akhlut/OSPID/OSPID/arduino pid motor C/arduino pid motor C/pid2.png

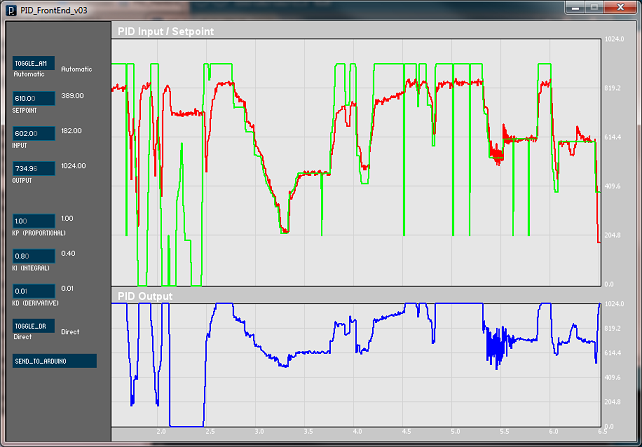
OSPID/arduino pid motor C/arduino pid motor C/pid2.png
