akhlut/OSPID/OSPID/arduino pid motor C/arduino pid motor C/readme.txt

copy LCD4Bit and pid folders in to arduino libraries.

compile and burn to chip.

schematic is made in proteus.

fell free to modify and improve it :D

have fun
