akhlut/OSPID/OSPID/5cbmyt.jpg

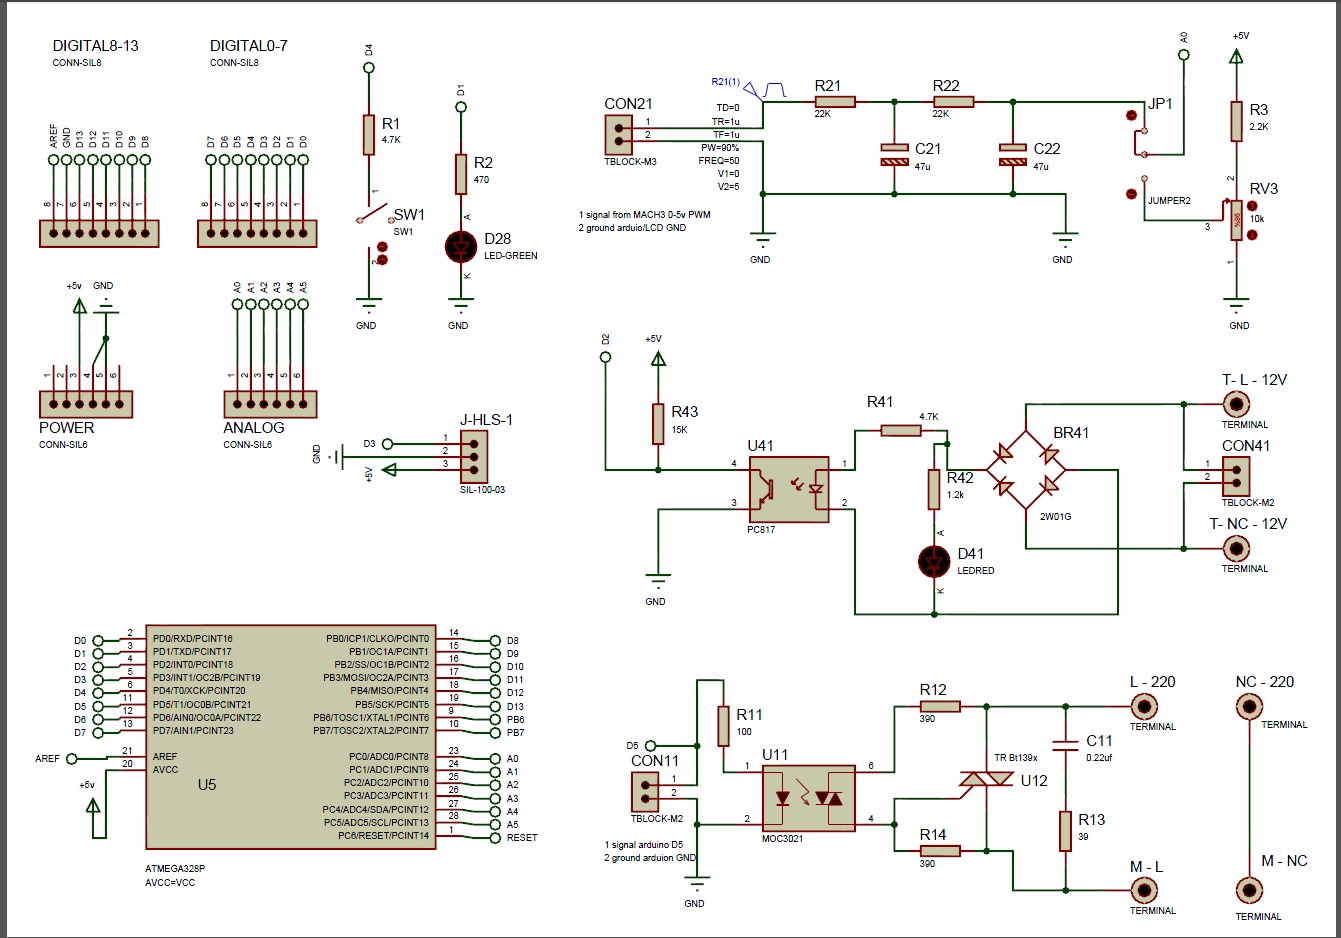
OSPID/5cbmyt.jpg
