akhlut/OSPID/OSPID/arduino pid motor C/arduino pid motor C/arduino-zero-1.do.bmp

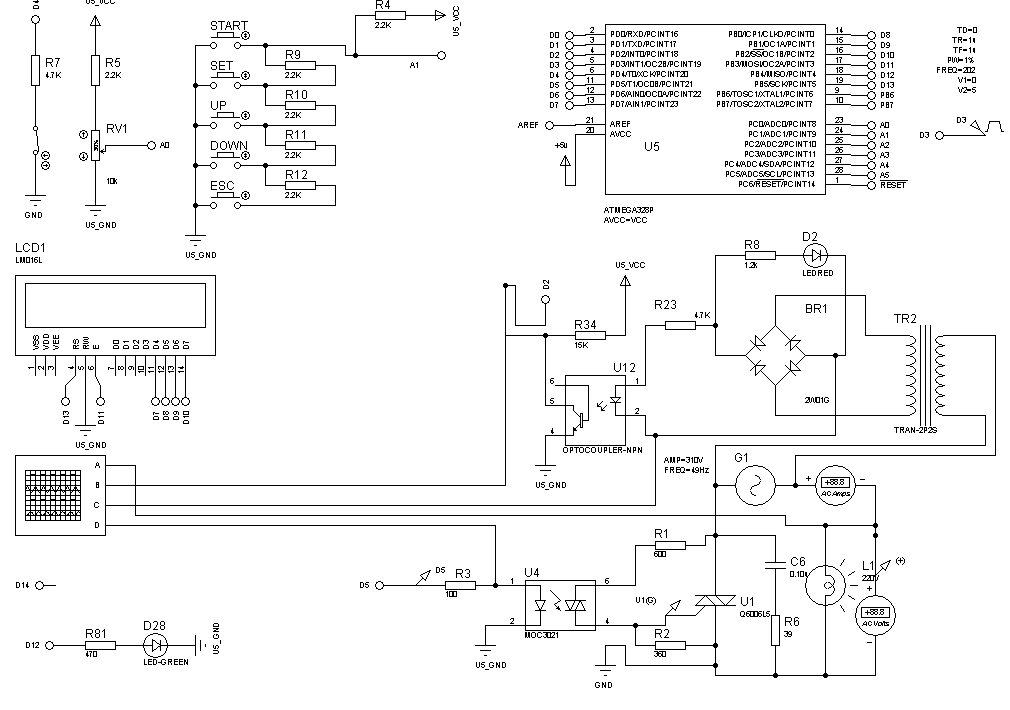
OSPID/arduino pid motor C/arduino pid motor C/arduino-zero-1.do.bmp
