akhlut/OSPID/OSPID/eagle2.bmp

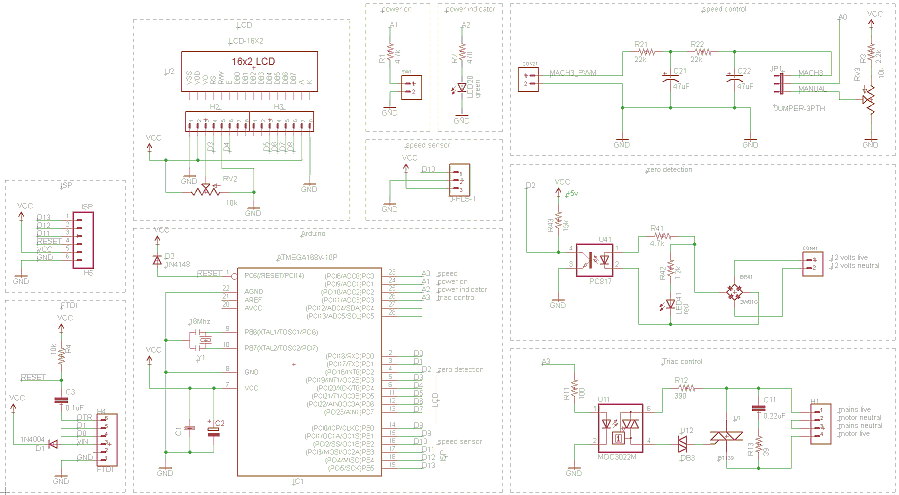
OSPID/eagle2.bmp
