akhlut/OSPID/OSPID/phase84_v0_4170.jpg

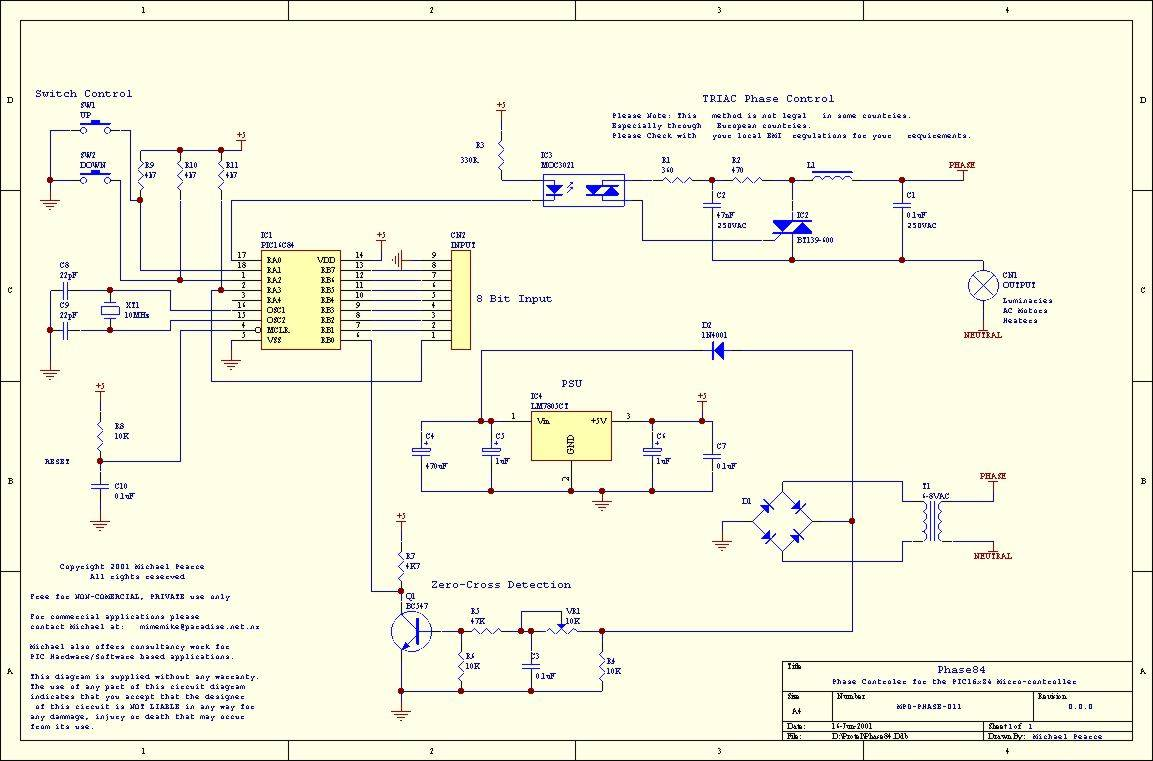
OSPID/phase84_v0_4170.jpg
