akhlut/OSPID/OSPID/SpindlePidLcdCopper (1).bmp

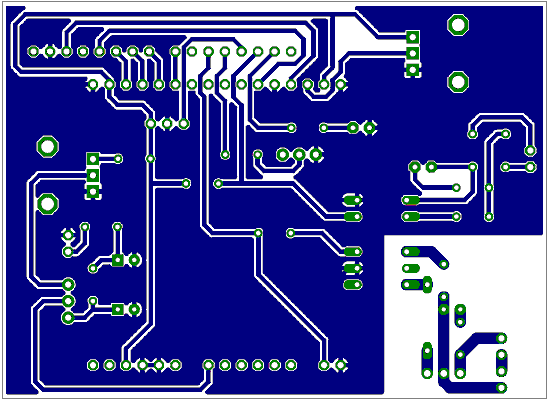
OSPID/SpindlePidLcdCopper (1).bmp
