akhlut/OSPID/pcb/LCD pcb/final.dxf

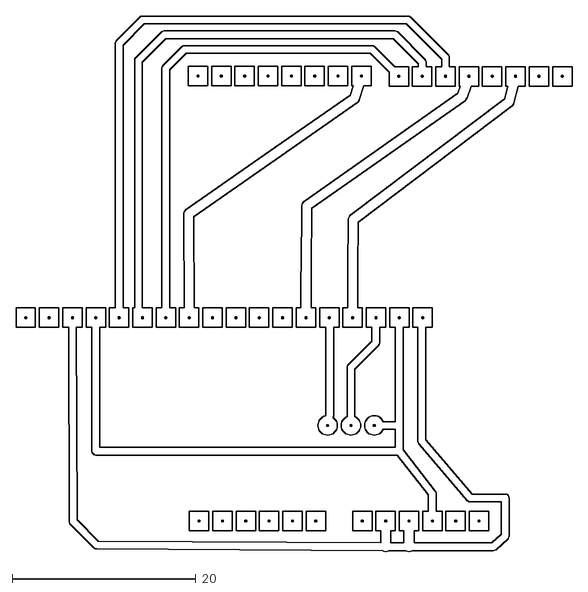
[picture p7: CAD file, 2013-12-27]
pcb/LCD pcb/final.dxf
60.5 x 58.3
