akhlut/OSPID/pcb/Main pcb/last-2-mill.dxf

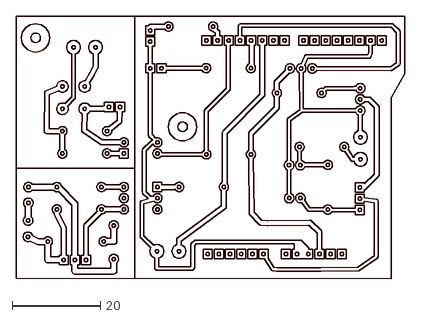
[picture p8: CAD file, 2013-12-27]
pcb/Main pcb/last-2-mill.dxf
88.3 x 59.8
