akhlut/OSPID/pcb/LCD pcb/GERBVIEW.DXF

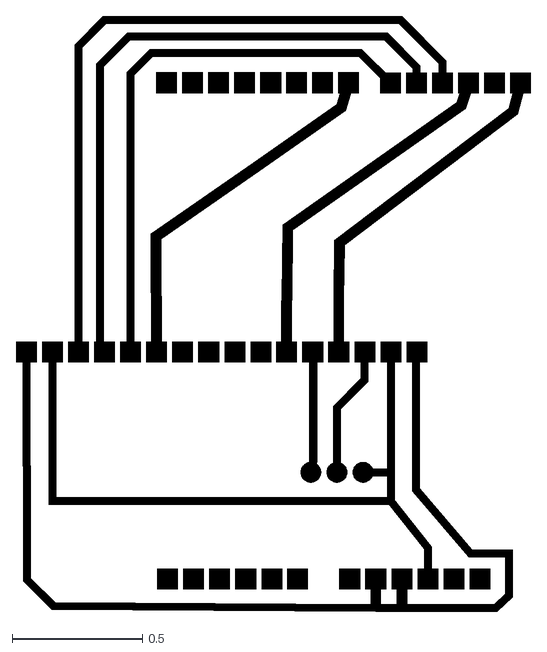
[picture p9: CAD file, 2013-12-27]
pcb/LCD pcb/GERBVIEW.DXF
1.98 x 2.28
