akhlut/OSPID/pcb/Main pcb/last-2.dxf

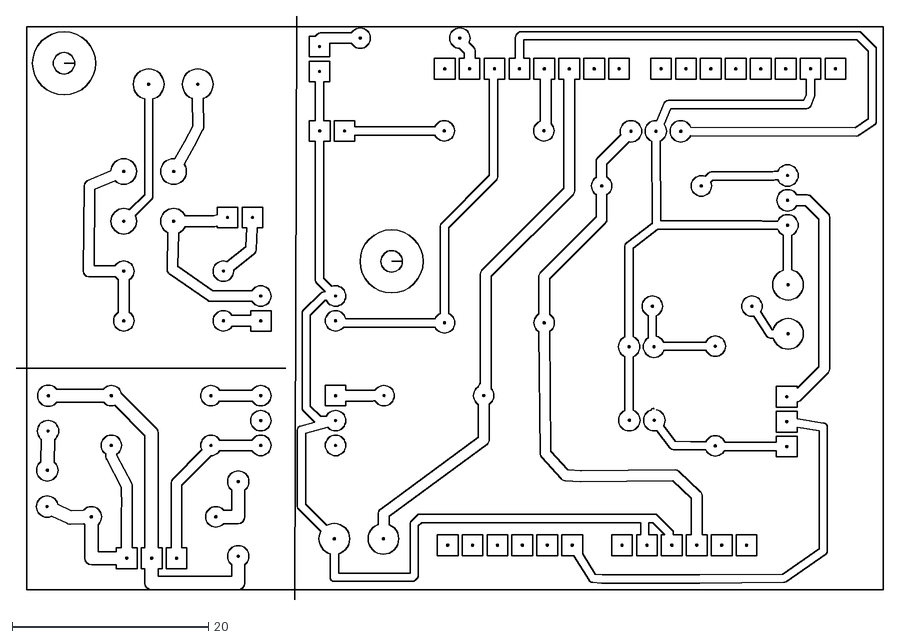
[picture p10: CAD file, 2013-12-27]
pcb/Main pcb/last-2.dxf
88.4 x 59.5
