akhlut/OSPID/OSPID/SpindlePID/SpindlePID.pdf

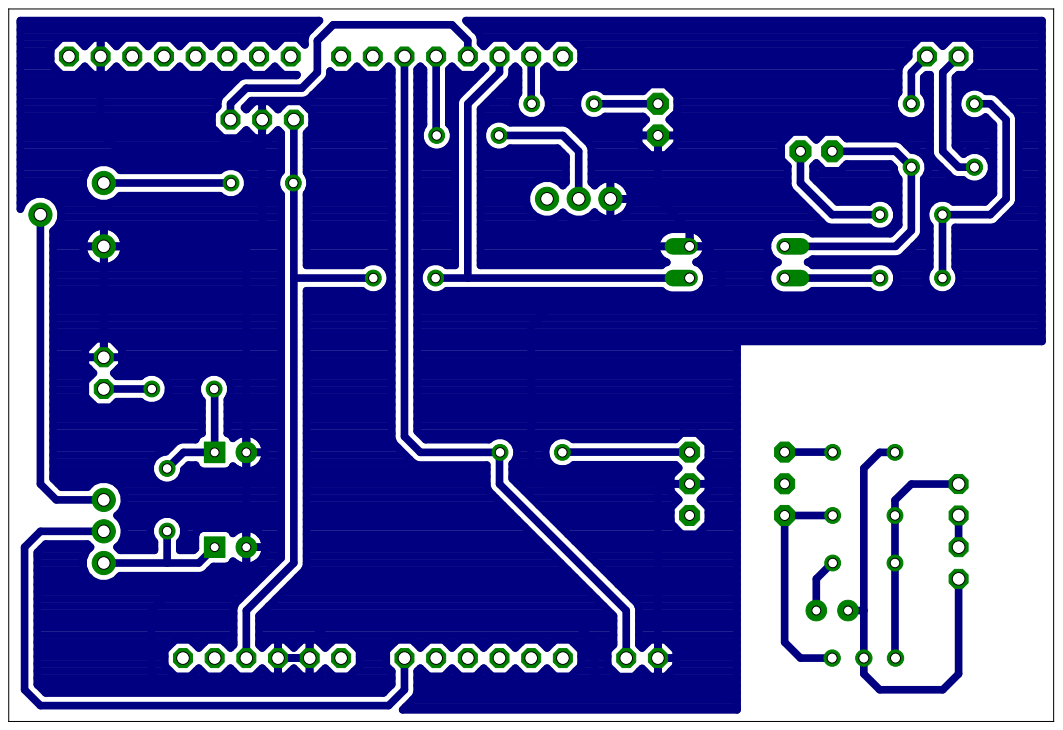
[picture p43: page 1]
