akhlut/OSPID/(list of files, drawings)

Other design files:
OpenSpindle/OpenSpindle BASE.dsn
OSPID/arduino pid motor C/arduino pid motor C/Arduino-Zero-1-n-3(Proteus).DSN
pcb/LCD pcb/Arduino-Zero-1-n-7-LCD-SHIELD.DSN
pcb/LCD pcb/Arduino-Zero-1-n-7-LCD-SHIELD.LYT
pcb/LCD pcb/GERBVIEW.LYT
pcb/Main pcb/GERBVIEW.LYT
