akhlut/OSPID/OSPID/OSPID/OSPID4.brd

## EAGLE design OSPID/OSPID/OSPID4.brd (2013-12-27)

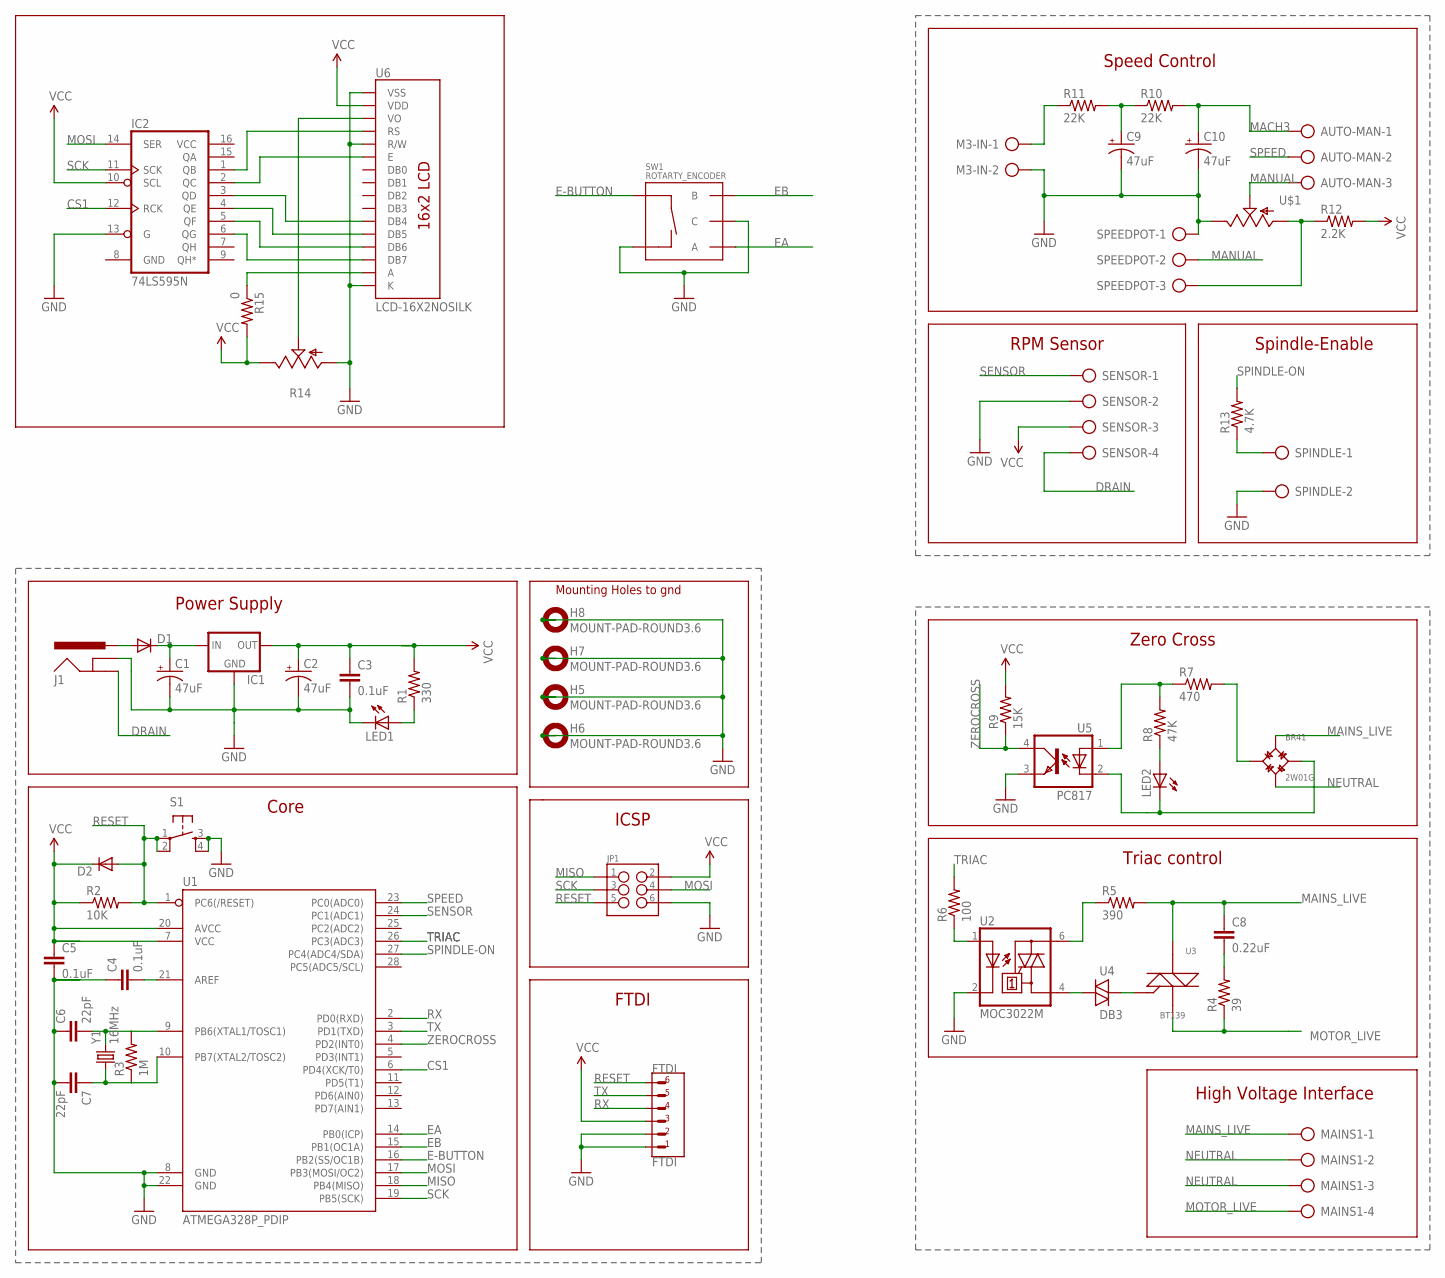
[picture p44: schematic OSPID4.sch]

Parts:
AUTO-MAN: AK500/3
BR41: 2W01G; DIODEBRIDGE
C1, C2, C9, C10: 47uF; CPOL-RADIAL-10UF-25V
C3, C4, C5: 0.1uF; CAP-PTH-SMALL
C6, C7: 22pF; CAP-PTH-SMALL
C8: 0.22uF; CAP-PTH-SMALL
D1, D2: DIODEPTH; DIODE-1N4001
FTDI: FTDI; 6PINHEADER
H5, H6, H7, H8: MOUNT-PAD-ROUND3.6; 3,6-PAD
IC1: V_REG_78XX-TO-220; TO-220-ALT
IC2: 74LS595N; DIL16
J1: POWER_JACKPTH_LOCK; POWER_JACK_PTH_LOCK
JP1: M03X2POGO_PINS; 2X3_POGO
LED1, LED2: LED5MM
M3-IN: AK500/2
MAINS1: AK500/4
R1: 330; AXIAL-0.3
R2: 10K; AXIAL-0.3
R3: 1M; AXIAL-0.3
R4: 39; AXIAL-0.3
R5: 390; AXIAL-0.3
R6: 100; AXIAL-0.3
R7: 470; SQM_5-10
R8: 47K; SQM_5-10
R9: 15K; AXIAL-0.3
R10, R11: 22K; AXIAL-0.3
R12: 2.2K; AXIAL-0.3
R13: 4.7K; AXIAL-0.3
R14: POT_TRIM_US-B25U; POT_B25U
R15: 0; AXIAL-0.3
S1: TAC_SWITCHPTH; TACTILE-PTH
SENSOR: AK500/4
SPEEDPOT: AK500/3
SPINDLE: AK500/2
SW1: ROTARTY_ENCODER; ROTARY_ENC_PLAIN
U1: ATMEGA328P_PDIP; DIL28-3
U2: MOC3022M; DIL06
U3: BT139; TRIAC
U4: DB3; DO35-10
U5: PC817; DIL04
U6: LCD-16X2NOSILK; LCD-16X2_NOSILK
U$1: POT; ALPS_POT
Y1: 16MHz; HC49U-V

Connections:
CS1: IC2.12 (RCK), U1.6 (PD4(XCK/T0))
DRAIN: J1.GND, SENSOR.4
E-BUTTON: SW1.SW+, U1.16 (PB2(SS/OC1B))
EA: SW1.A, U1.14 (PB0(ICP))
EB: SW1.B, U1.15 (PB1(OC1A))
GND: C1.2 (-), C2.2 (-), C3.2, C4.1, C5.2, C6.1, C7.2, C9.2 (-), C10.2 (-), FTDI.P$1, FTDI.P$2, H5.B3,6, H6.B3,6, H7.B3,6, H8.B3,6, IC1.GND, IC2.8 (GND), IC2.13 (G), J1.GNDBREAK, JP1.P$6 (6), LED1.K (C), M3-IN.2, R14.A, S1.3, S1.4, SENSOR.2, SPEEDPOT.1, SPINDLE.2, SW1.C, SW1.SW-, U1.8 (GND), U1.22 (GND), U2.2 (C), U5.3 (EMIT), U6.1 (VSS), U6.5 (R/W), U6.16 (K), U$1.P$1 (E)
MACH3: AUTO-MAN.1, C10.1 (+), R10.P$2 (2)
MACH3_PWM: M3-IN.1, R11.P$1 (1)
MAINS_LIVE: BR41.AC1, C8.1, MAINS1.1, R5.P$2 (2), U3.2 (A)
MANUAL: AUTO-MAN.3, SPEEDPOT.2, U$1.P$2 (S)
MISO: JP1.P$1 (1), U1.18 (PB4(MISO))
MOSI: IC2.14 (SER), JP1.P$4 (4), U1.17 (PB3(MOSI/OC2))
MOTOR_LIVE: MAINS1.4, R4.P$1 (1), U3.3 (C)
unnamed: U3.1 (B), U4.C (2)
unnamed: C9.1 (+), R10.P$1 (1), R11.P$2 (2)
unnamed: U2.4 (A1), U4.A (1)
unnamed: LED1.A, R1.P$1 (1)
unnamed: C8.2, R4.P$2 (2)
unnamed: R7.P1 (1), R8.P2 (2), U5.1 (A)
unnamed: BR41.-, LED2.K (C), U5.2 (C)
unnamed: LED2.A, R8.P1 (1)
unnamed: R12.P$1 (1), SPEEDPOT.3, U$1.P$3 (A)
unnamed: R13.P$1 (1), SPINDLE.1
unnamed: R6.P$1 (1), U2.1 (A)
unnamed: R14.S, U6.3 (VO)
unnamed: R5.P$1 (1), U2.6 (A2)
unnamed: R15.P$1 (1), U6.15 (A)
unnamed: IC2.1 (QB), U6.4 (RS)
unnamed: IC2.2 (QC), U6.6 (E)
unnamed: C7.1, R3.P$1 (1), U1.10 (PB7(XTAL2/TOSC2)), Y1.1
unnamed: IC2.6 (QG), U6.14 (DB7)
unnamed: C6.2, R3.P$2 (2), U1.9 (PB6(XTAL1/TOSC1)), Y1.2
unnamed: IC2.5 (QF), U6.13 (DB6)
unnamed: IC2.4 (QE), U6.12 (DB5)
unnamed: C1.1 (+), D1.C, IC1.IN
unnamed: D1.A, J1.PWR
unnamed: IC2.3 (QD), U6.11 (DB4)
unnamed: C4.2, U1.21 (AREF)
unnamed: BR41.+, R7.P2 (2)
NEUTRAL: BR41.AC2, MAINS1.2, MAINS1.3
RESET: D2.A, FTDI.P$6, JP1.P$5 (5), R2.P$2 (2), S1.1, S1.2, U1.1 (PC6(/RESET))
RX: FTDI.P$4, U1.2 (PD0(RXD))
SCK: IC2.11 (SCK), JP1.P$3 (3), U1.19 (PB5(SCK))
SENSOR: SENSOR.1, U1.24 (PC1(ADC1))
SPEED: AUTO-MAN.2, U1.23 (PC0(ADC0))
SPINDLE-ON: R13.P$2 (2), U1.27 (PC4(ADC4/SDA))
TRIAC: R6.P$2 (2), U1.26 (PC3(ADC3))
TX: FTDI.P$5, U1.3 (PD1(TXD))
VCC: C2.1 (+), C3.1, C5.1, D2.C, FTDI.P$3, IC1.OUT, IC2.10 (SCL), IC2.16 (VCC), JP1.P$2 (2), R1.P$2 (2), R2.P$1 (1), R9.P$2 (2), R12.P$2 (2), R14.E, R15.P$2 (2), SENSOR.3, U1.7 (VCC), U1.20 (AVCC), U6.2 (VDD)
ZEROCROSS: R9.P$1 (1), U1.4 (PD2(INT0)), U5.4 (COL)

Notes on the sheet:
Speed Control
RPM Sensor
Spindle-Enable
Power Supply
Triac control
Zero Cross
FTDI
Core
ICSP
High Voltage Interface
Mounting Holes to gnd

Board: 2 copper layers, 55 parts (0 on the bottom side), 50 nets, no tracks yet.
