akhlut/OSPID/OSPID/StandAlone/SpindlePidLcdStandAlone.brd

## EAGLE design OSPID/StandAlone/SpindlePidLcdStandAlone.brd (2013-12-27)

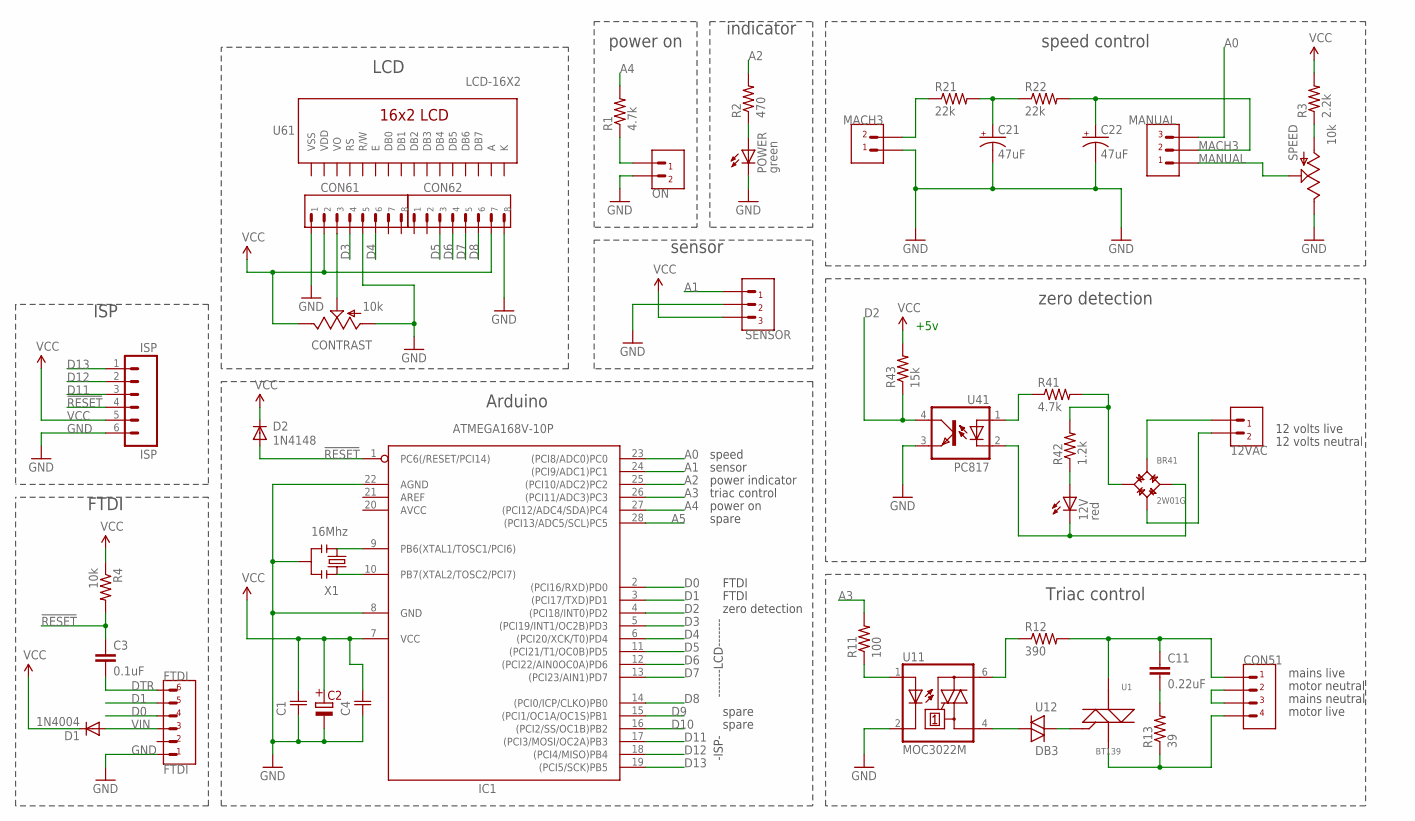
[picture p45: schematic SpindlePidLcdStandAlone.sch]

Parts:
12V: red; LED5MM
12VAC: 2PIN
BR41: 2W01G; DIODEBRIDGE
C1, C4: 0.1UF
C2: CAPACITOR
C3: 0.1uF; CAP-PTH-SMALL
C11: 0.22uF; CAP-PTH-SMALL
C21, C22: 47uF; CPOL-RADIAL-10UF-25V
CON51: 4PIN
CON61, CON62: 8PINHEADER
CONTRAST: 10k; ALPS_POT
D1: 1N4004; DO41-10
D2: 1N4148; DO41-10
FTDI: FTDI; 6PINHEADER
IC1: ATMEGA168V-10P; DIL28-3
ISP: ISP; 1X06
MACH3: 2PIN
MANUAL: 3PIN
ON: 2PIN
POWER: green; LED5MM
R1: 4.7k; AXIAL-0.4
R2: 470; 1/6W-RES
R3: 2.2k; 1/6W-RES
R4: 10k; AXIAL-0.4
R11: 100; 1/6W-RES
R12: 390; 1/6W-RES
R13: 39; 1/6W-RES
R21, R22: 22k; 1/6W-RES
R41: 4.7k; 1/6W-RES
R42: 1.2k; 1/6W-RES
R43: 15k; 1/6W-RES
SENSOR: 3PIN
SPEED: 10k; ALPS_POT
U1: BT139; TRIAC
U11: MOC3022M; DIL06
U12: DB3; DO35-10
U41: PC817; DIL04
U61: LCD-16X2
X1: 16Mhz; RESONATOR-PTH

Connections:
!RESET: C3.1, D2.A, IC1.1 (PC6(/RESET/PCI14)), ISP.4, R4.P$2 (2)
A: U61.15 (A)
A0: IC1.23 ((PCI8/ADC0)PC0), MANUAL.P$3 (3)
A1: IC1.24 ((PCI9/ADC1)PC1), SENSOR.P$1 (1)
A2: IC1.25 ((PCI10/ADC2)PC2), R2.2
A3: IC1.26 ((PCI11/ADC3)PC3), R11.2
A4: IC1.27 ((PCI12/ADC4/SDA)PC4), R1.P$2 (2)
A5: IC1.28 ((PCI13/ADC5/SCL)PC5)
D0: FTDI.P$4, IC1.2 ((PCI16/RXD)PD0)
D1: FTDI.P$5, IC1.3 ((PCI17/TXD)PD1)
D2: IC1.4 ((PCI18/INT0)PD2), R43.1, U41.4 (COL)
D3: CON61.P$4, IC1.5 ((PCI19/INT1/OC2B)PD3)
D4: CON61.P$6, IC1.6 ((PCI20/XCK/T0)PD4)
D5: CON62.P$3, IC1.11 ((PCI21/T1/OC0B)PD5)
D6: CON62.P$4, IC1.12 ((PCI22/AIN0OC0A)PD6)
D7: CON62.P$5, IC1.13 ((PCI23/AIN1)PD7)
D8: CON62.P$6, IC1.14 ((PCI0/ICP/CLKO)PB0)
D9: IC1.15 ((PCI1/OC1A/OC1S)PB1)
D10: IC1.16 ((PCI2/SS/OC1B)PB2)
D11: IC1.17 ((PCI3/MOSI/OC2A)PB3), ISP.3
D12: IC1.18 ((PCI4/MISO)PB4), ISP.2
D13: IC1.19 ((PCI5/SCK)PB5), ISP.1
DTR: C3.2, FTDI.P$6
GND: C1.P$1, C2.- (-VE), C4.P$1, C21.2 (-), C22.2 (-), CON61.P$1, CON61.P$5, CON62.P$8, CONTRAST.P$3 (A), FTDI.P$1, IC1.8 (GND), IC1.22 (AGND), ISP.6, MACH3.P$1, ON.P$2, POWER.K (C), SENSOR.P$2 (2), SPEED.P$1 (E), U11.2 (C), U41.3 (EMIT), X1.2
K: U61.16 (K)
MACH3: C22.1 (+), MANUAL.P$2 (2), R22.2
MACH3_PWM: MACH3.P$2, R21.1
MAINS_LIVE: C11.1, CON51.P$1, R12.2, U1.2 (A)
MANUAL: MANUAL.P$1 (1), SPEED.P$2 (S)
MOTOR_LIVE: CON51.P$4, R13.1, U1.3 (C)
unnamed: U1.1 (B), U12.C (2)
unnamed: C21.1 (+), R21.2, R22.1
unnamed: U11.4 (A1), U12.A (1)
unnamed: POWER.A, R2.1
unnamed: C11.2, R13.2
unnamed: 12V.A, R42.1
unnamed: R41.1, U41.1 (A)
unnamed: 12V.K (C), BR41.-, U41.2 (C)
unnamed: BR41.+, R41.2, R42.2
unnamed: R3.1, SPEED.P$3 (A)
unnamed: IC1.9 (PB6(XTAL1/TOSC1/PCI6)), X1.1
unnamed: ON.P$1, R1.P$1 (1)
unnamed: R11.1, U11.1 (A)
unnamed: 12VAC.P$1, BR41.AC1
unnamed: R12.1, U11.6 (A2)
unnamed: 12VAC.P$2, BR41.AC2
unnamed: CON61.P$3, CONTRAST.P$2 (S)
unnamed: IC1.10 (PB7(XTAL2/TOSC2/PCI7)), X1.3
NEUTRAL: CON51.P$2, CON51.P$3
VCC: C1.P$2, C2.+ (+VE), C4.P$2, CON61.P$2, CON62.P$7, CONTRAST.P$1 (E), D1.C, D2.C, IC1.7 (VCC), ISP.5, R3.2, R4.P$1 (1), R43.2, SENSOR.P$3 (3)
VDD: U61.2 (VDD)
VIN: D1.A, FTDI.P$3
VSS: U61.1 (VSS)

Notes on the sheet:
+5v
speed control
Arduino
sensor
power on
indicator
Triac control
zero detection
motor live
mains live
mains neutral
motor neutral
12 volts live
12 volts neutral
FTDI
ISP
LCD
-------LCD-------
-ISP-
speed
power indicator
triac control
spare

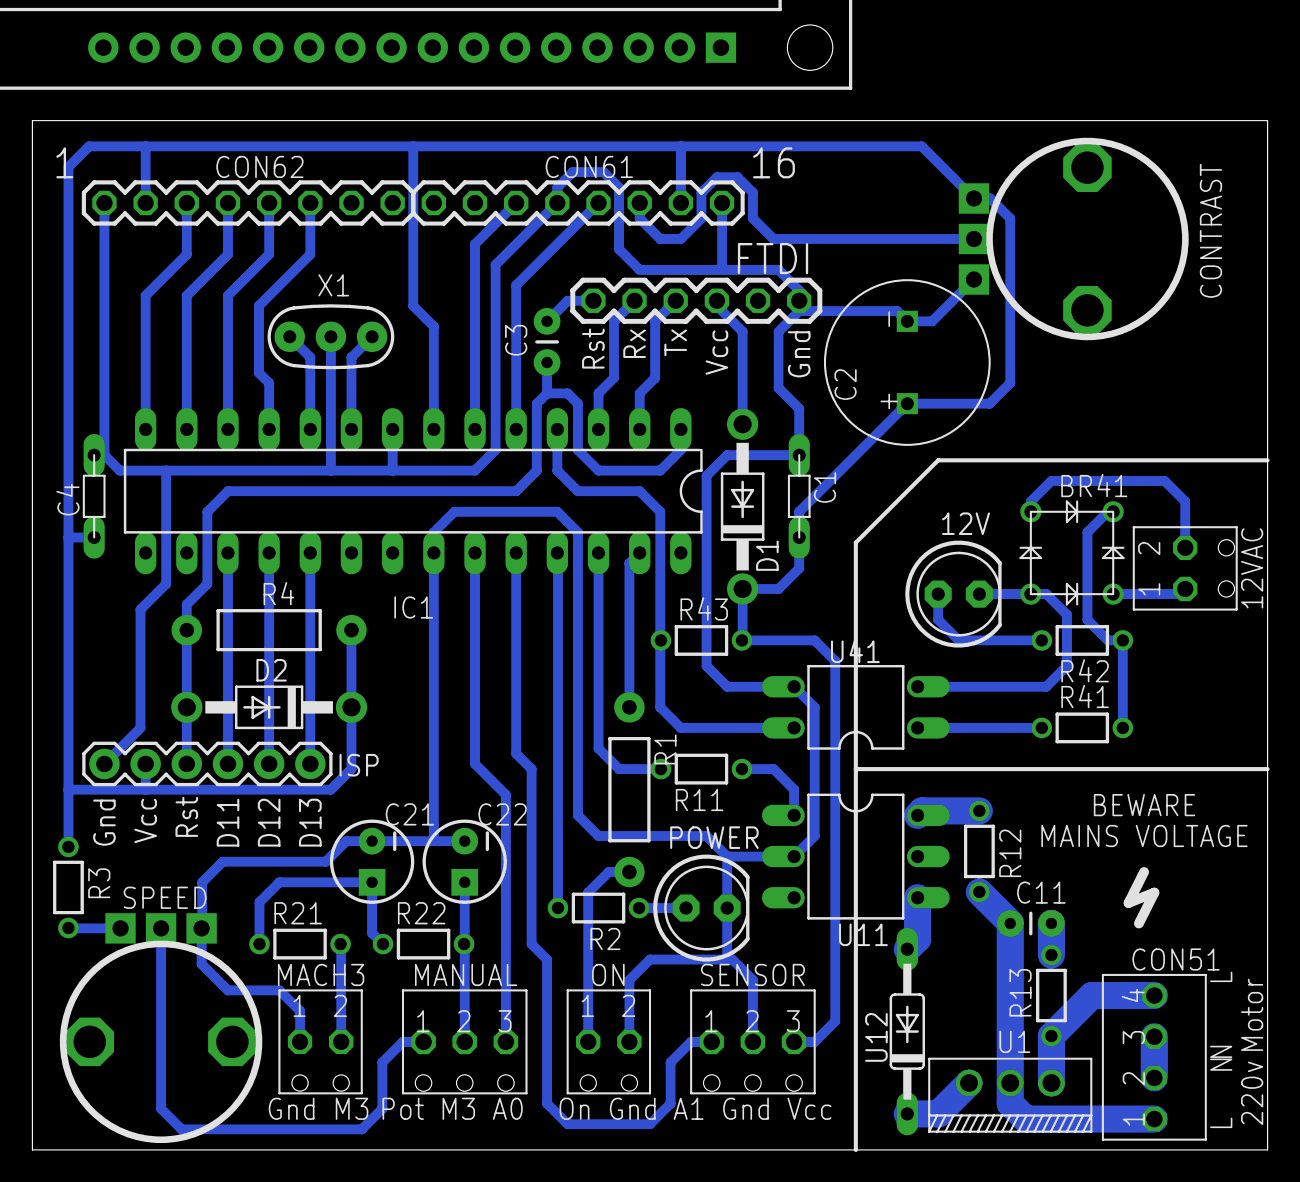
[picture p46: board SpindlePidLcdStandAlone.brd from above]

Board: 2 copper layers, 76.2 x 63.5 mm, 43 parts (0 on the bottom side), 46 nets.
