akhlut/OSPID/OSPID/SpindlePID/SpindlePID.brd

## EAGLE design OSPID/SpindlePID/SpindlePID.brd (2013-12-27)

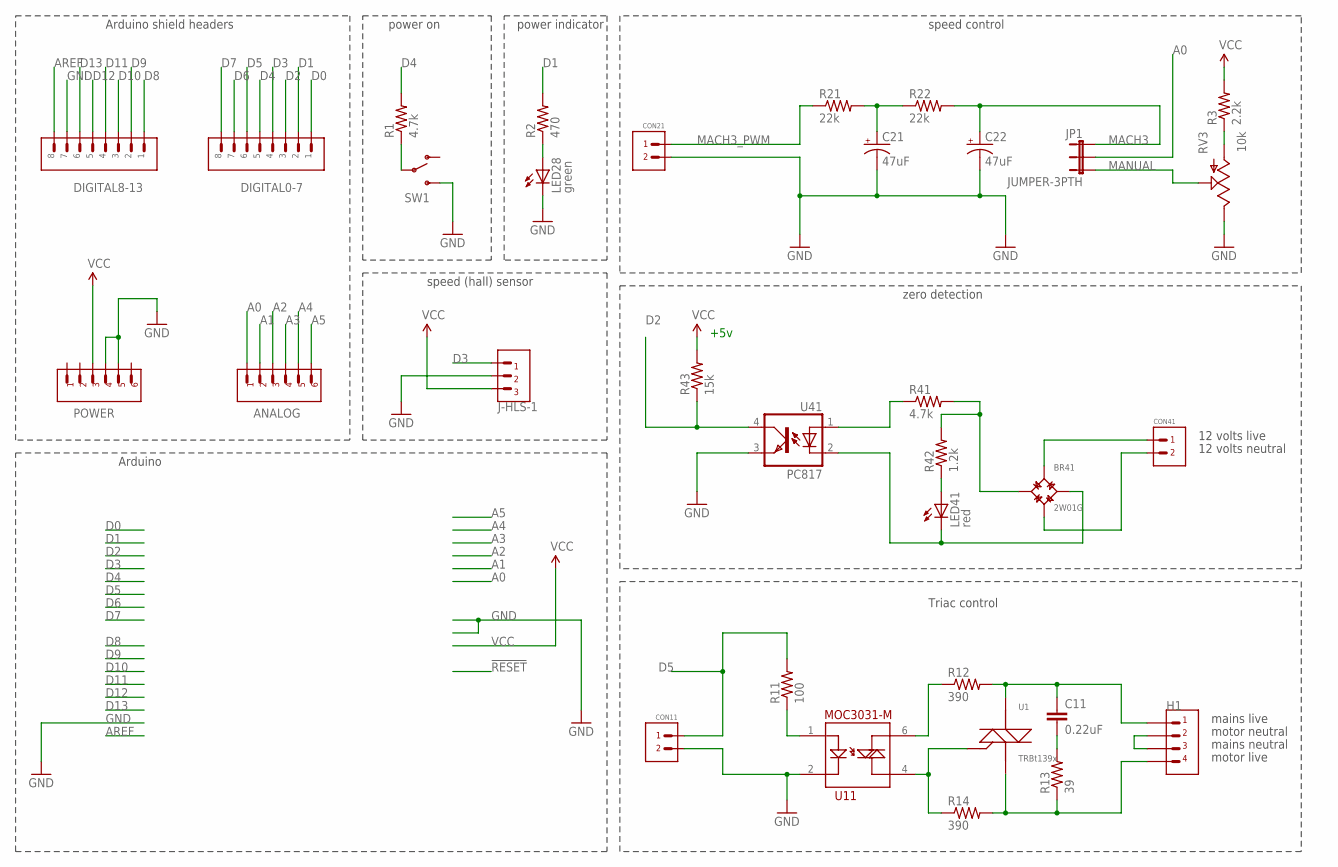
[picture p47: schematic SpindlePID.sch]

Parts:
ANALOG: 6PINHEADER0.1"; 6PINHEADER
BR41: 2W01G; DIODEBRIDGE
C11: 0.22uF; CAP-PTH-SMALL
C21, C22: 47uF; CPOL-RADIAL-10UF-25V
CON11, CON21, CON41: 2PINHEADER
DIGITAL0-7, DIGITAL8-13: 8PINHEADER
H1: 4PIN
J-HLS-1: 3PINHEADER
JP1: JUMPER-3PTH; 1X03
LED28: green; LED5MM
LED41: red; LED5MM
POWER: 6PINHEADER0.1"; 6PINHEADER
R1, R41: 4.7k; 1/6W-RES
R2: 470; 1/6W-RES
R3: 2.2k; 1/6W-RES
R11: 100; 1/6W-RES
R12, R14: 390; 1/6W-RES
R13: 39; 1/6W-RES
R21, R22: 22k; 1/6W-RES
R42: 1.2k; 1/6W-RES
R43: 15k; 1/6W-RES
RV3: 10k; TRIM_POT
SW1: SWITCH-SPSTPTH; SWITCH-SPDT
U1: TRBt139x; TRIAC
U11: MOC3031-M; DIL06
U41: PC817; DIL04

Connections:
A0: ANALOG.P$1, JP1.2
A1: ANALOG.P$2
A2: ANALOG.P$3
A3: ANALOG.P$4
A4: ANALOG.P$5
A5: ANALOG.P$6
AREF: DIGITAL8-13.P$8
D0: DIGITAL0-7.P$1
D1: DIGITAL0-7.P$2, R2.2
D2: DIGITAL0-7.P$3, R43.1, U41.4 (COL)
D3: DIGITAL0-7.P$4, J-HLS-1.P$3
D4: DIGITAL0-7.P$5, R1.2
D5: CON11.P$1, DIGITAL0-7.P$6, R11.2
D6: DIGITAL0-7.P$7
D7: DIGITAL0-7.P$8
D8: DIGITAL8-13.P$1
D9: DIGITAL8-13.P$2
D10: DIGITAL8-13.P$3
D11: DIGITAL8-13.P$4
D12: DIGITAL8-13.P$5
D13: DIGITAL8-13.P$6
GND: C21.2 (-), C22.2 (-), CON11.P$2, CON21.P$2, DIGITAL8-13.P$7, J-HLS-1.P$2, LED28.K (C), POWER.P$4, POWER.P$5, RV3.2 (E), SW1.3 (S), U11.2, U41.3 (EMIT)
MACH3: C22.1 (+), JP1.1, R22.2
MACH3_PWM: CON21.P$1, R21.1
MAINS_LIVE: C11.1, H1.P$1, R12.2, U1.2 (A)
MANUAL: JP1.3, RV3.1 (S)
MOTOR_LIVE: H1.P$4, R13.1, R14.2, U1.3 (C)
unnamed: C21.1 (+), R21.2, R22.1
unnamed: R14.1, U1.1 (B), U11.4
unnamed: LED28.A, R2.1
unnamed: C11.2, R13.2
unnamed: LED41.A, R42.1
unnamed: R41.1, U41.1 (A)
unnamed: BR41.-, LED41.K (C), U41.2 (C)
unnamed: BR41.+, R41.2, R42.2
unnamed: R3.1, RV3.3 (A)
unnamed: R1.1, SW1.2
unnamed: R11.1, U11.1
unnamed: BR41.AC1, CON41.P$1
unnamed: R12.1, U11.6
unnamed: BR41.AC2, CON41.P$2
NEUTRAL: H1.P$2, H1.P$3
VCC: J-HLS-1.P$1, POWER.P$3, R3.2, R43.2

Notes on the sheet:
+5v
speed control
Arduino shield headers
Arduino
speed (hall) sensor
power on
power indicator
Triac control
zero detection
motor live
mains live
mains neutral
motor neutral
12 volts live
12 volts neutral

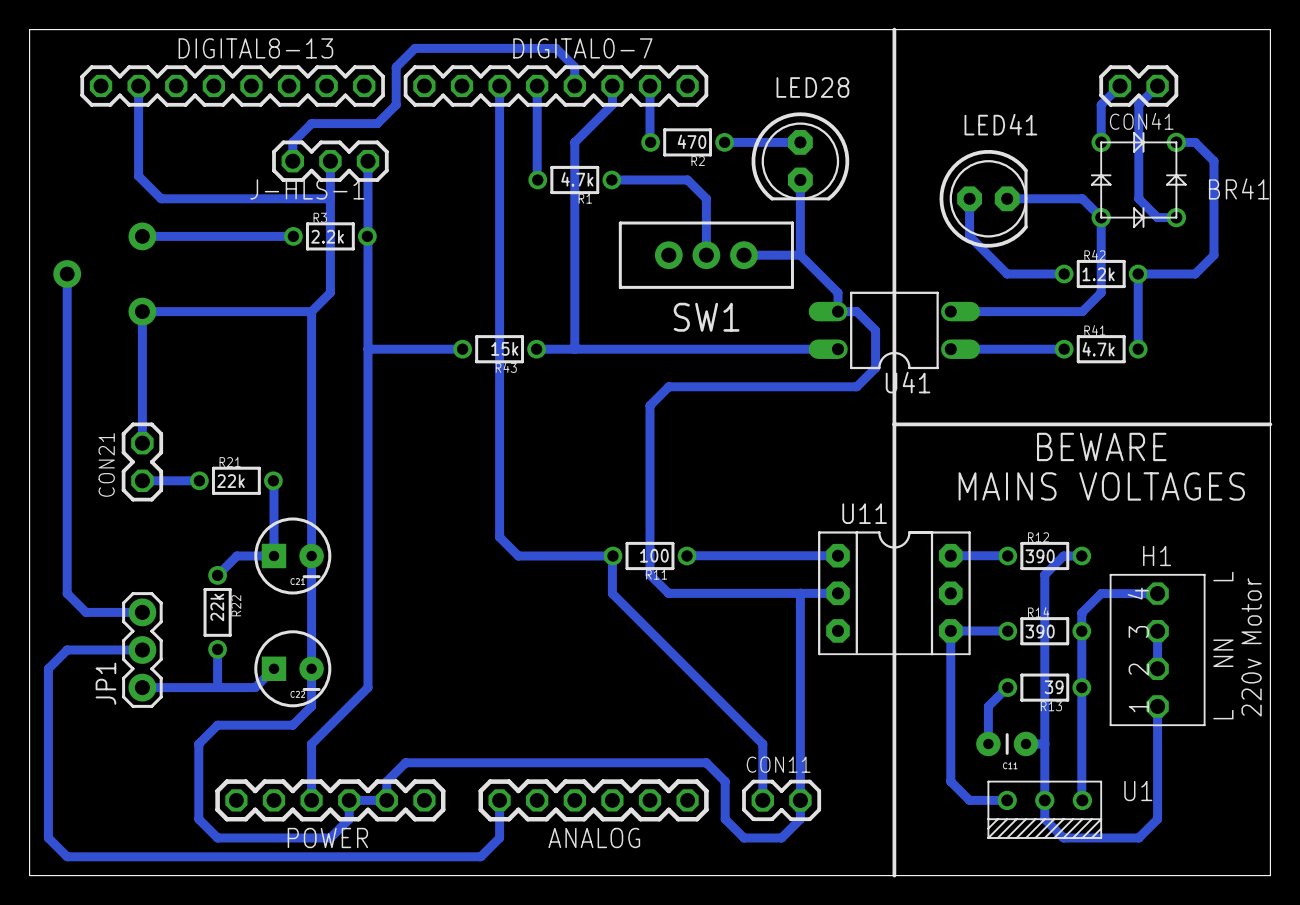
[picture p48: board SpindlePID.brd from above]

Board: 2 copper layers, 83.8 x 57.1 mm, 33 parts (0 on the bottom side), 28 nets.
