akhlut/OSPID/OSPID/OSPID/OSPID IO Board.brd

## EAGLE design OSPID/OSPID/OSPID IO Board.brd (2013-12-27)

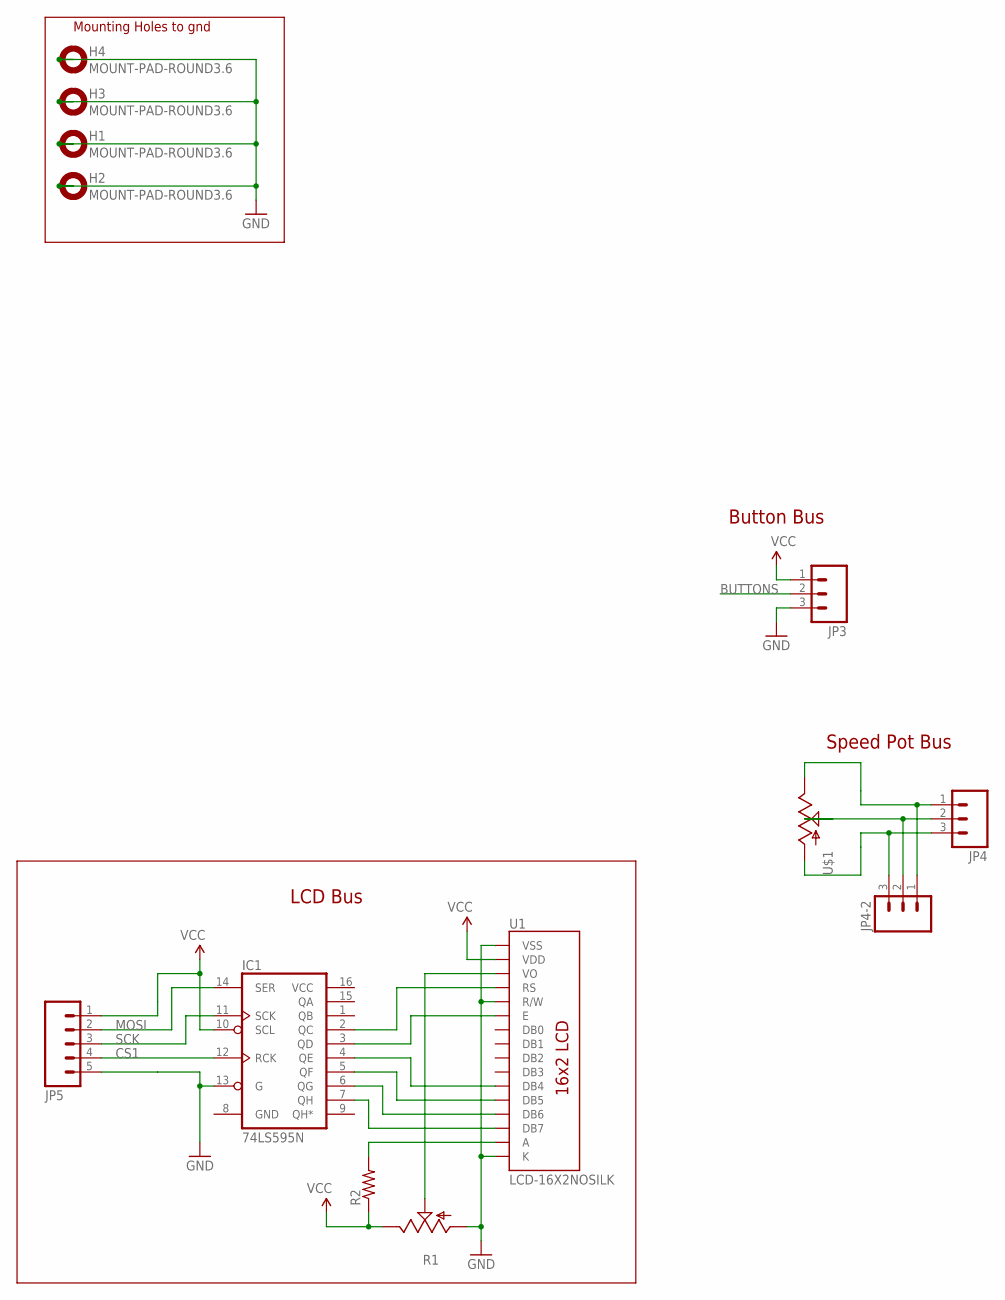
[picture p49: schematic OSPID IO Board.sch]

Parts:
H1, H2, H3, H4: MOUNT-PAD-ROUND3.6; 3,6-PAD
IC1: 74LS595N; DIL16
JP3, JP4, JP4-2: M03LOCK; 1X03_LOCK
JP5: M05LOCK; 1X05_LOCK
R1: POT_TRIM_US-B25U; POT_B25U
R2: RESISTORAXIAL-0.3; AXIAL-0.3
U1: LCD-16X2NOSILK; LCD-16X2_NOSILK
U$1: POT; ALPS_POT

Connections:
BUTTONS: JP3.2
CS1: IC1.12 (RCK), JP5.4
GND: H1.B3,6, H2.B3,6, H3.B3,6, H4.B3,6, IC1.8 (GND), IC1.13 (G), JP3.3, JP5.5, R1.A, U1.1 (VSS), U1.5 (R/W), U1.16 (K)
MOSI: IC1.14 (SER), JP5.2
unnamed: JP4.3, JP4-2.3, U$1.P$3 (A)
unnamed: R2.P$2 (2), U1.15 (A)
unnamed: JP4.2, JP4-2.2, U$1.P$2 (S)
unnamed: JP4.1, JP4-2.1, U$1.P$1 (E)
unnamed: IC1.4 (QE), U1.11 (DB4)
unnamed: IC1.2 (QC), U1.4 (RS)
unnamed: IC1.3 (QD), U1.6 (E)
unnamed: R1.S, U1.3 (VO)
unnamed: IC1.5 (QF), U1.12 (DB5)
unnamed: IC1.6 (QG), U1.13 (DB6)
unnamed: IC1.7 (QH), U1.14 (DB7)
SCK: IC1.11 (SCK), JP5.3
VCC: IC1.10 (SCL), IC1.16 (VCC), JP3.1, JP5.1, R1.E, R2.P$1 (1), U1.2 (VDD)

Notes on the sheet:
Button Bus
LCD Bus
Mounting Holes to gnd
Speed Pot Bus

Board: 2 copper layers, 13 parts (0 on the bottom side), 16 nets, no tracks yet.
