akhlut/OSPID/OSPID/OSPID/OSPID.brd

## EAGLE design OSPID/OSPID/OSPID.brd (2013-12-27)

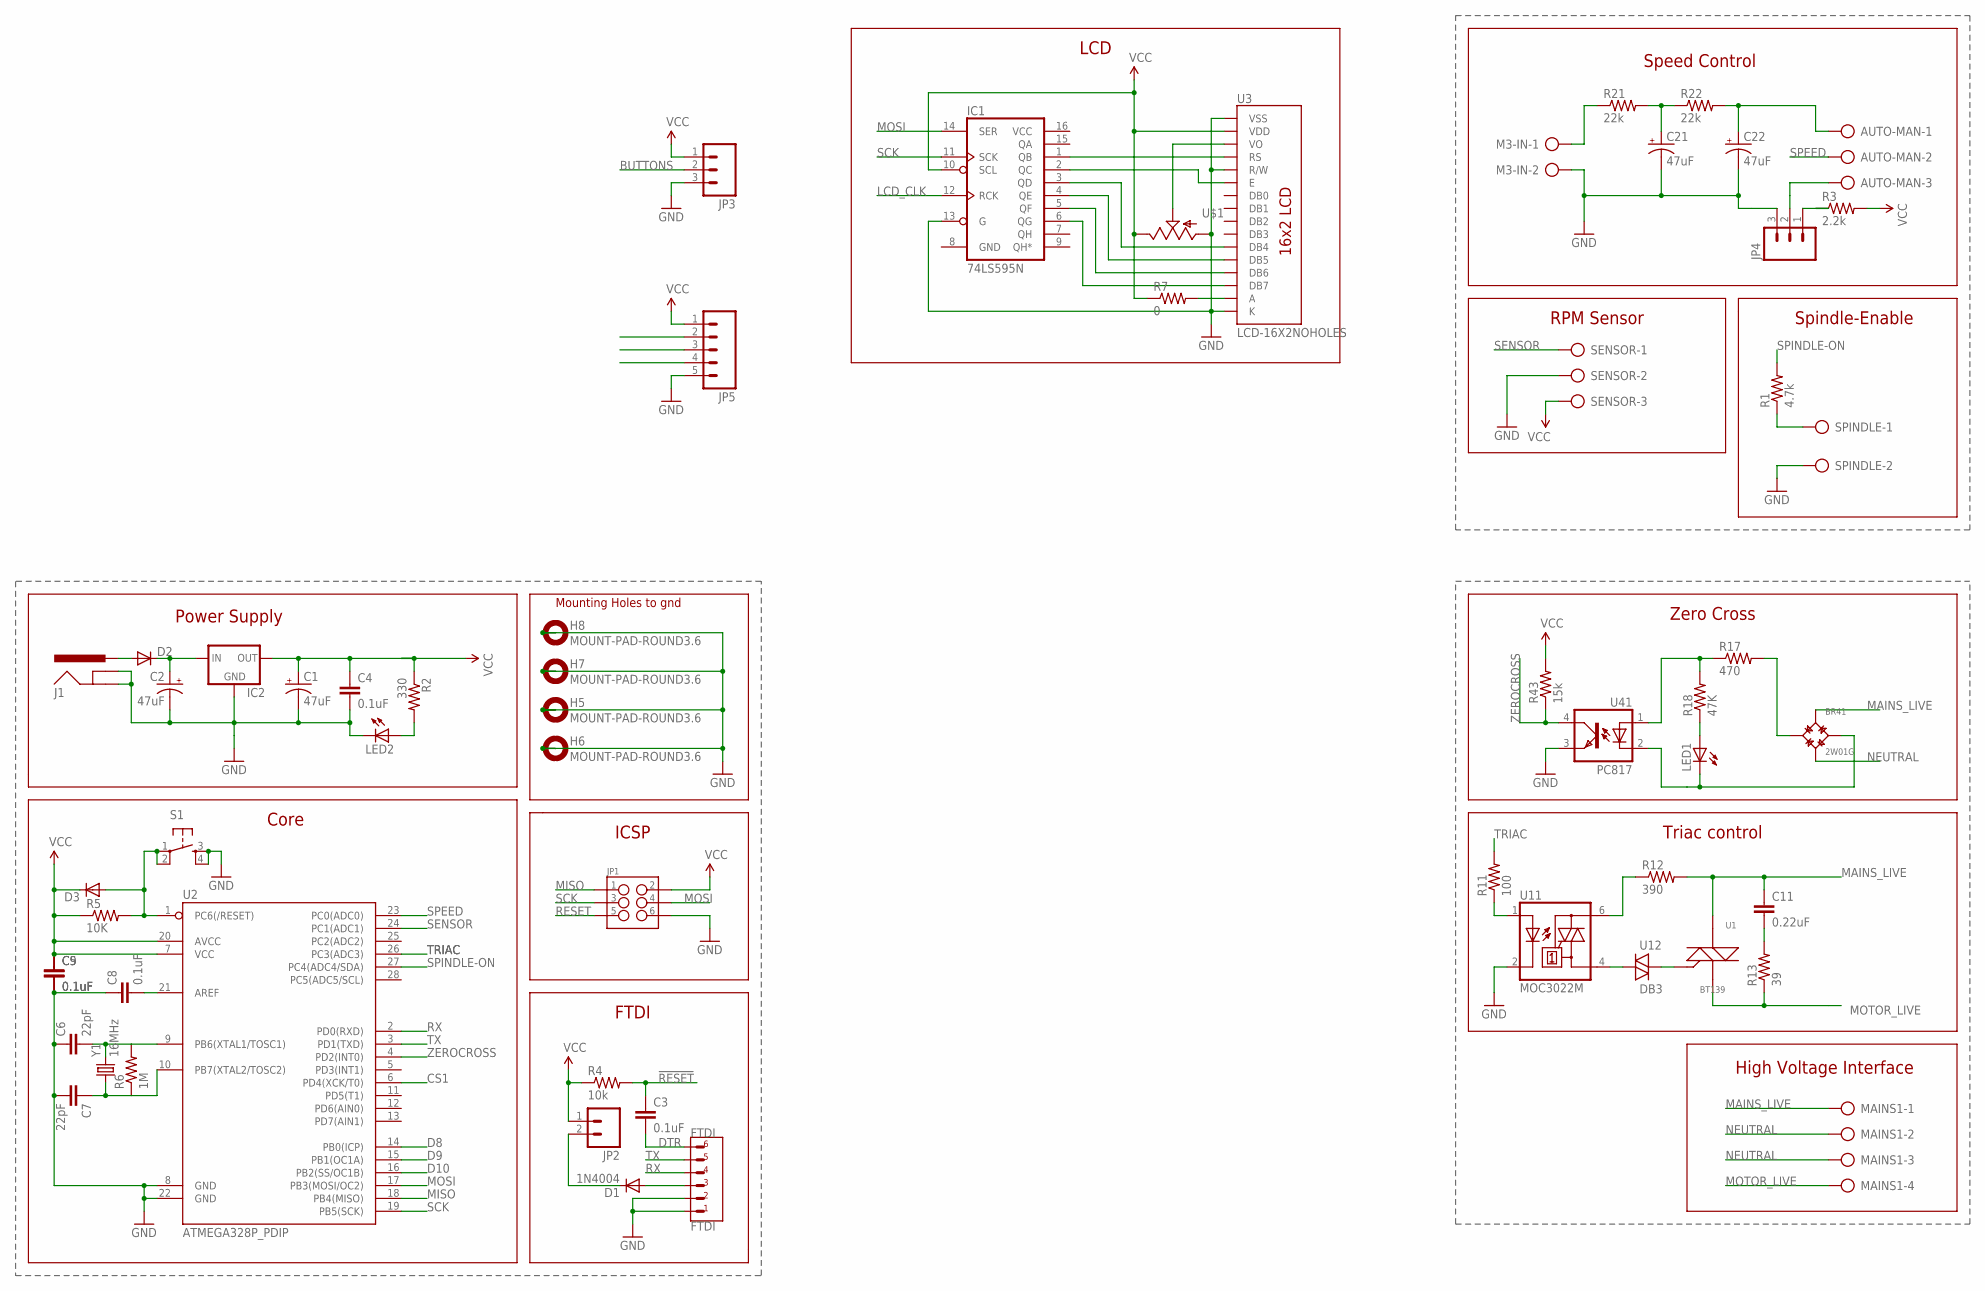
[picture p50: schematic OSPID.sch]

Parts:
AUTO-MAN: AK500/3
BR41: 2W01G; DIODEBRIDGE
C1, C2: 47uF; CPOL-RADIAL-100UF-25V
C3, C4, C5, C8, C9: 0.1uF; CAP-PTH-SMALL
C6, C7: 22pF; CAP-PTH-SMALL
C11: 0.22uF; CAP-PTH-SMALL
C21, C22: 47uF; CPOL-RADIAL-10UF-25V
D1: 1N4004; DO41-10
D2, D3: DIODEPTH; DIODE-1N4001
FTDI: FTDI; 6PINHEADER
H5, H6, H7, H8: MOUNT-PAD-ROUND3.6; 3,6-PAD
IC1: 74LS595N; DIL16
IC2: V_REG_78XX-TO-220; TO-220-ALT
J1: POWER_JACKPTH_LOCK; POWER_JACK_PTH_LOCK
JP1: M03X2POGO_PINS; 2X3_POGO
JP2: M02LOCK; 1X02_LOCK
JP3, JP4: M03LOCK; 1X03_LOCK
JP5: M05LOCK; 1X05_LOCK
LED1, LED2: LED5MM
M3-IN: AK500/2
MAINS1: AK500/4
R1: 4.7k; AXIAL-0.4
R2: 330; 1/6W-RES
R3: 2.2k; 1/6W-RES
R4: 10k; AXIAL-0.4
R5: 10K; AXIAL-0.3
R6: 1M; AXIAL-0.3
R7: 0; AXIAL-0.3
R11: 100; 1/6W-RES
R12: 390; 1/6W-RES
R13: 39; 1/6W-RES
R17: 470; SQM_5-10
R18: 47K; SQM_5-10
R21, R22: 22k; 1/6W-RES
R43: 15k; 1/6W-RES
S1: TAC_SWITCHPTH; TACTILE-PTH
SENSOR: AK500/3
SPINDLE: AK500/2
U1: BT139; TRIAC
U2: ATMEGA328P_PDIP; DIL28-3
U3: LCD-16X2NOHOLES; LCD-16X2_NOHOLES
U11: MOC3022M; DIL06
U12: DB3; DO35-10
U41: PC817; DIL04
U$1: POTTRIM; TRIM_POT
Y1: 16MHz; HC49U-V

Connections:
!RESET: C3.1, R4.P$2 (2)
BUTTONS: JP3.2
CS1: JP5.4, U2.6 (PD4(XCK/T0))
D8: U2.14 (PB0(ICP))
D9: U2.15 (PB1(OC1A))
D10: U2.16 (PB2(SS/OC1B))
DTR: C3.2, FTDI.P$6
GND: C1.2 (-), C2.2 (-), C4.2, C5.2, C6.1, C7.2, C8.1, C9.2, C21.2 (-), C22.2 (-), FTDI.P$1, FTDI.P$2, H5.B3,6, H6.B3,6, H7.B3,6, H8.B3,6, IC1.8 (GND), IC1.13 (G), IC2.GND, J1.GND, J1.GNDBREAK, JP1.P$6 (6), JP3.3, JP4.3, JP5.5, LED2.K (C), M3-IN.2, S1.3, S1.4, SENSOR.2, SPINDLE.2, U2.8 (GND), U2.22 (GND), U3.1 (VSS), U3.5 (R/W), U3.16 (K), U11.2 (C), U41.3 (EMIT), U$1.3 (A)
LCD_CLK: IC1.12 (RCK)
MACH3: AUTO-MAN.1, C22.1 (+), R22.2
MACH3_PWM: M3-IN.1, R21.1
MAINS_LIVE: BR41.AC1, C11.1, MAINS1.1, R12.2, U1.2 (A)
MANUAL: AUTO-MAN.3, JP4.2
MISO: JP1.P$1 (1), U2.18 (PB4(MISO))
MOSI: IC1.14 (SER), JP1.P$4 (4), JP5.2, U2.17 (PB3(MOSI/OC2))
MOTOR_LIVE: MAINS1.4, R13.1, U1.3 (C)
unnamed: U1.1 (B), U12.C (2)
unnamed: C21.1 (+), R21.2, R22.1
unnamed: U11.4 (A1), U12.A (1)
unnamed: LED2.A, R2.2
unnamed: C11.2, R13.2
unnamed: R17.P1 (1), R18.P2 (2), U41.1 (A)
unnamed: BR41.-, LED1.K (C), U41.2 (C)
unnamed: LED1.A, R18.P1 (1)
unnamed: JP4.1, R3.1
unnamed: U3.3 (VO), U$1.1 (S)
unnamed: R1.P$1 (1), SPINDLE.1
unnamed: R11.1, U11.1 (A)
unnamed: IC1.1 (QB), U3.4 (RS)
unnamed: R12.1, U11.6 (A2)
unnamed: IC1.2 (QC), U3.6 (E)
unnamed: IC1.3 (QD), U3.11 (DB4)
unnamed: IC1.4 (QE), U3.12 (DB5)
unnamed: D3.A, R5.P$2 (2), S1.1, S1.2, U2.1 (PC6(/RESET))
unnamed: C7.1, R6.P$1 (1), U2.10 (PB7(XTAL2/TOSC2)), Y1.1
unnamed: R7.P$2 (2), U3.15 (A)
unnamed: C6.2, R6.P$2 (2), U2.9 (PB6(XTAL1/TOSC1)), Y1.2
unnamed: IC1.5 (QF), U3.13 (DB6)
unnamed: IC1.6 (QG), U3.14 (DB7)
unnamed: C2.1 (+), D2.C, IC2.IN
unnamed: D2.A, J1.PWR
unnamed: D1.C, JP2.2
unnamed: C8.2, U2.21 (AREF)
unnamed: BR41.+, R17.P2 (2)
NEUTRAL: BR41.AC2, MAINS1.2, MAINS1.3
RESET: JP1.P$5 (5)
RX: FTDI.P$4, U2.2 (PD0(RXD))
SCK: IC1.11 (SCK), JP1.P$3 (3), JP5.3, U2.19 (PB5(SCK))
SENSOR: SENSOR.1, U2.24 (PC1(ADC1))
SPEED: AUTO-MAN.2, U2.23 (PC0(ADC0))
SPINDLE-ON: R1.P$2 (2), U2.27 (PC4(ADC4/SDA))
TRIAC: R11.2, U2.26 (PC3(ADC3))
TX: FTDI.P$5, U2.3 (PD1(TXD))
VCC: C1.1 (+), C4.1, C5.1, C9.1, D3.C, IC1.10 (SCL), IC1.16 (VCC), IC2.OUT, JP1.P$2 (2), JP2.1, JP3.1, JP5.1, R2.1, R3.2, R4.P$1 (1), R5.P$1 (1), R7.P$1 (1), R43.2, SENSOR.3, U2.7 (VCC), U2.20 (AVCC), U3.2 (VDD), U$1.2 (E)
VIN: D1.A, FTDI.P$3
ZEROCROSS: R43.1, U2.4 (PD2(INT0)), U41.4 (COL)

Notes on the sheet:
Speed Control
RPM Sensor
Spindle-Enable
Power Supply
Triac control
Zero Cross
FTDI
LCD
Core
ICSP
High Voltage Interface
Mounting Holes to gnd

Board: 2 copper layers, 60 parts (0 on the bottom side), 50 nets, no tracks yet.
