akhlut/OSPID/OpenSpindle/OpenSpindle BASE.brd

## EAGLE design OpenSpindle/OpenSpindle BASE.brd (2013-12-27)

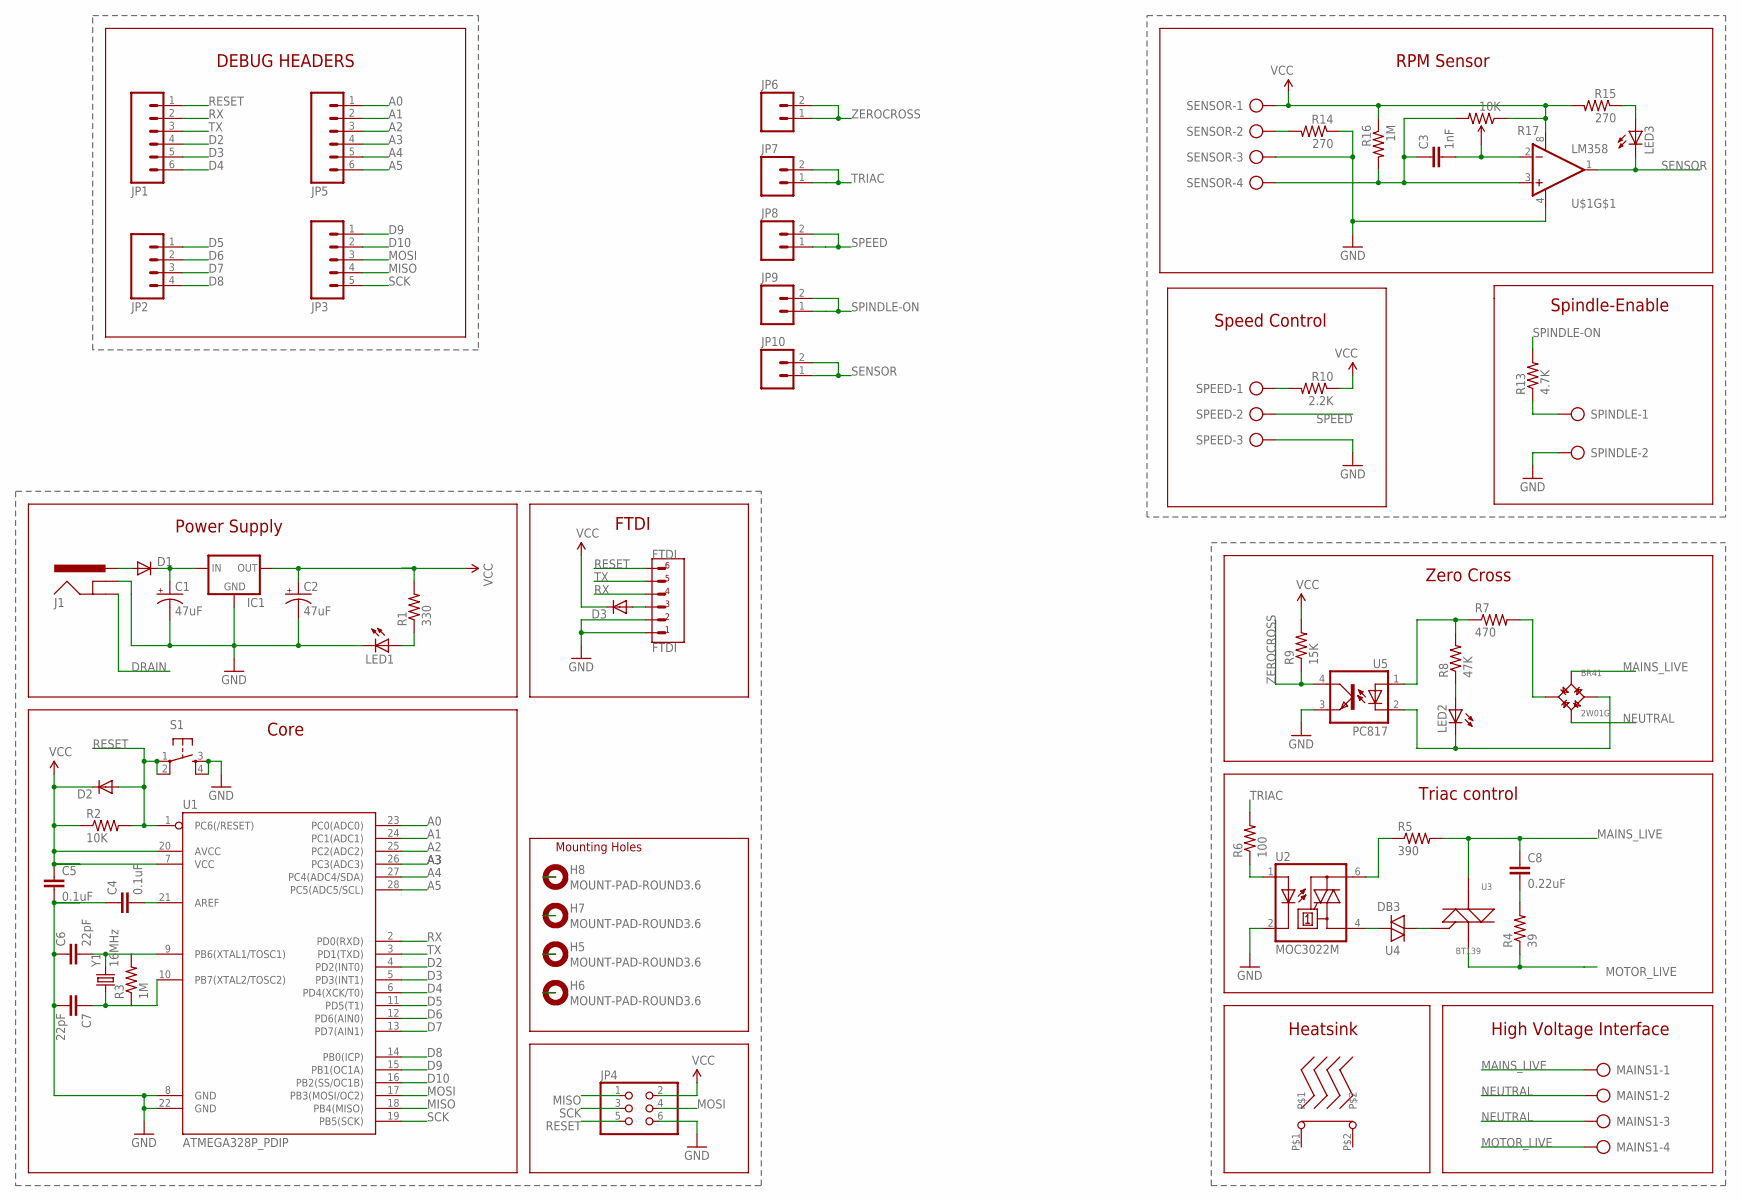
[picture p51: schematic OpenSpindle BASE.sch]

Parts:
BR41: 2W01G; DIODEBRIDGE
C1, C2: 47uF; CPOL-RADIAL-10UF-25V
C3: 1nF; CAP-PTH-SMALL
C4, C5: 0.1uF; CAP-PTH-SMALL
C6, C7: 22pF; CAP-PTH-SMALL
C8: 0.22uF; CAP-PTH-SMALL
D1, D2, D3: DIODEPTH; DIODE-1N4001
FTDI: FTDI; 6PINHEADER
H5, H6, H7, H8: MOUNT-PAD-ROUND3.6; 3,6-PAD
IC1: V_REG_78XX-TO-220; TO-220-ALT
J1: POWER_JACKPTH_LOCK; POWER_JACK_PTH_LOCK
JP1, JP5: M06LOCK; 1X06_LOCK
JP2: M04LOCK; 1X04_LOCK
JP3: M05LOCK; 1X05_LOCK
JP4: PINHD-2X3; 2X03
JP6, JP7, JP8, JP9, JP10: M02LOCK; 1X02_LOCK
LED1, LED2, LED3: LED5MM
MAINS1: AK500/4
R1: 330; AXIAL-0.3
R2: 10K; AXIAL-0.3
R3, R16: 1M; AXIAL-0.3
R4: 39; AXIAL-0.3
R5: 390; AXIAL-0.3
R6: 100; AXIAL-0.3
R7: 470; SQM_5-10
R8: 47K; SQM_5-10
R9: 15K; AXIAL-0.3
R10: 2.2K; AXIAL-0.3
R13: 4.7K; AXIAL-0.3
R14, R15: 270; AXIAL-0.3
R17: 10K; TRIMPOT_PTH_S3_LOCK
S1: TAC_SWITCHPTH; TACTILE-PTH
SENSOR: AK500/4
SPEED: AK500/3
SPINDLE: AK500/2
U1: ATMEGA328P_PDIP; DIL28-3
U2: MOC3022M; DIL06
U3: BT139; TRIAC
U4: DB3; DO35-10
U5: PC817; DIL04
U$1: LM358; DIP08
U$2: HEATSINK529802B02500G; 529802B02500G
Y1: 16MHz; HC49U-V

Connections:
A0: JP5.1, U1.23 (PC0(ADC0))
A1: JP5.2, U1.24 (PC1(ADC1))
A2: JP5.3, U1.25 (PC2(ADC2))
A3: JP5.4, U1.26 (PC3(ADC3))
A4: JP5.5, U1.27 (PC4(ADC4/SDA))
A5: JP5.6, U1.28 (PC5(ADC5/SCL))
D2: JP1.4, U1.4 (PD2(INT0))
D3: JP1.5, U1.5 (PD3(INT1))
D4: JP1.6, U1.6 (PD4(XCK/T0))
D5: JP2.1, U1.11 (PD5(T1))
D6: JP2.2, U1.12 (PD6(AIN0))
D7: JP2.3, U1.13 (PD7(AIN1))
D8: JP2.4, U1.14 (PB0(ICP))
D9: JP3.1, U1.15 (PB1(OC1A))
D10: JP3.2, U1.16 (PB2(SS/OC1B))
DRAIN: J1.GND
GND: C1.2 (-), C2.2 (-), C4.1, C5.2, C6.1, C7.2, FTDI.P$1, FTDI.P$2, IC1.GND, J1.GNDBREAK, JP4.6, LED1.K (C), R14.P$1 (1), S1.3, S1.4, SENSOR.3, SPEED.3, SPINDLE.2, U1.8 (GND), U1.22 (GND), U2.2 (C), U5.3 (EMIT), U$1.4 (V-)
MAINS_LIVE: BR41.AC1, C8.1, MAINS1.1, R5.P$2 (2), U3.2 (A)
MISO: JP3.4, JP4.1, U1.18 (PB4(MISO))
MOSI: JP3.3, JP4.4, U1.17 (PB3(MOSI/OC2))
MOTOR_LIVE: MAINS1.4, R4.P$1 (1), U3.3 (C)
unnamed: U2.4 (A1), U4.C (2)
unnamed: R10.P$2 (2), SPEED.1
unnamed: U3.1 (B), U4.A (1)
unnamed: LED1.A, R1.P$1 (1)
unnamed: C8.2, R4.P$2 (2)
unnamed: R7.P1 (1), R8.P2 (2), U5.1 (A)
unnamed: BR41.-, LED2.K (C), U5.2 (C)
unnamed: LED2.A, R8.P1 (1)
unnamed: R13.P$1 (1), SPINDLE.1
unnamed: R6.P$1 (1), U2.1 (A)
unnamed: D3.A, FTDI.P$3
unnamed: R5.P$1 (1), U2.6 (A2)
unnamed: R14.P$2 (2), SENSOR.2
unnamed: C3.1, R16.P$2 (2), R17.3 (CW), SENSOR.4, U$1.3 (+IN)
unnamed: C7.1, R3.P$1 (1), U1.10 (PB7(XTAL2/TOSC2)), Y1.1
unnamed: C6.2, R3.P$2 (2), U1.9 (PB6(XTAL1/TOSC1)), Y1.2
unnamed: LED3.A, R15.P$1 (1)
unnamed: C1.1 (+), D1.C, IC1.IN
unnamed: D1.A, J1.PWR
unnamed: C3.2, R17.2 (WIPER), U$1.2 (-IN)
unnamed: C4.2, U1.21 (AREF)
unnamed: BR41.+, R7.P2 (2)
NEUTRAL: BR41.AC2, MAINS1.2, MAINS1.3
RESET: D2.A, FTDI.P$6, JP1.1, JP4.5, R2.P$2 (2), S1.1, S1.2, U1.1 (PC6(/RESET))
RX: FTDI.P$4, JP1.2, U1.2 (PD0(RXD))
SCK: JP3.5, JP4.3, U1.19 (PB5(SCK))
SENSOR: JP10.1, JP10.2, LED3.K (C), U$1.1 (OUT)
SPEED: JP8.1, JP8.2, SPEED.2
SPINDLE-ON: JP9.1, JP9.2, R13.P$2 (2)
TRIAC: JP7.1, JP7.2, R6.P$2 (2)
TX: FTDI.P$5, JP1.3, U1.3 (PD1(TXD))
VCC: C2.1 (+), C5.1, D2.C, D3.C, IC1.OUT, JP4.2, R1.P$2 (2), R2.P$1 (1), R9.P$2 (2), R10.P$1 (1), R15.P$2 (2), R16.P$1 (1), R17.1 (CCW), SENSOR.1, U1.7 (VCC), U1.20 (AVCC), U$1.8 (V+)
ZEROCROSS: JP6.1, JP6.2, R9.P$1 (1), U5.4 (COL)

Notes on the sheet:
Speed Control
RPM Sensor
Spindle-Enable
Power Supply
Triac control
Zero Cross
FTDI
Core
High Voltage Interface
Mounting Holes
Heatsink
DEBUG HEADERS

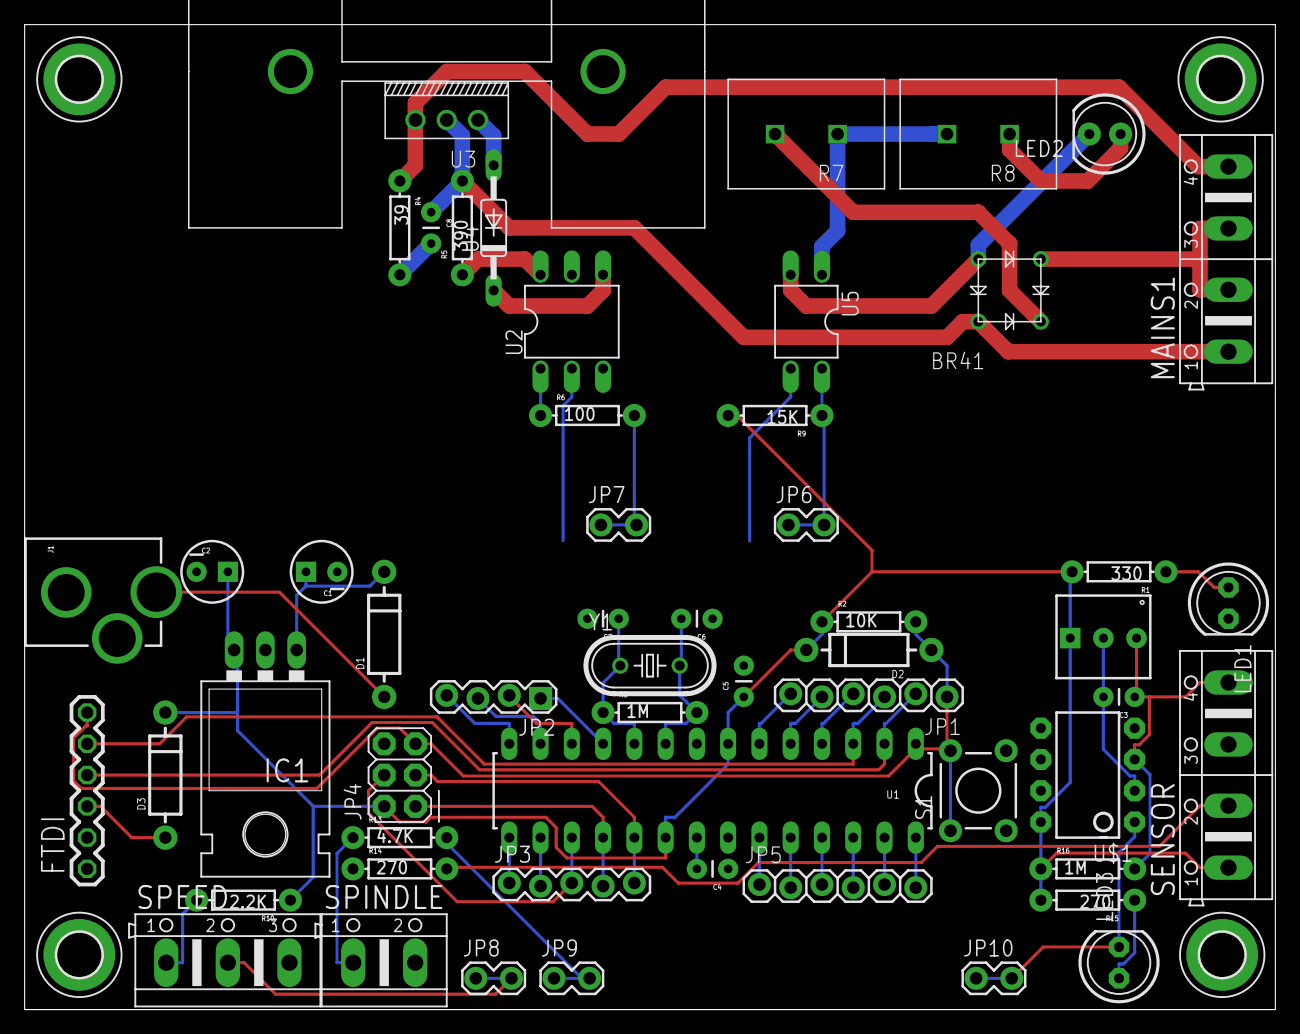
[picture p52: board OpenSpindle BASE.brd from above]

Board: 2 copper layers, 101.6 x 80.0 mm, 60 parts (0 on the bottom side), 53 nets.
