akhlut/OSPID/OpenSpindle/Grove - Infrared Reflective Sensor.brd

## EAGLE design OpenSpindle/Grove - Infrared Reflective Sensor.brd (2013-12-27)

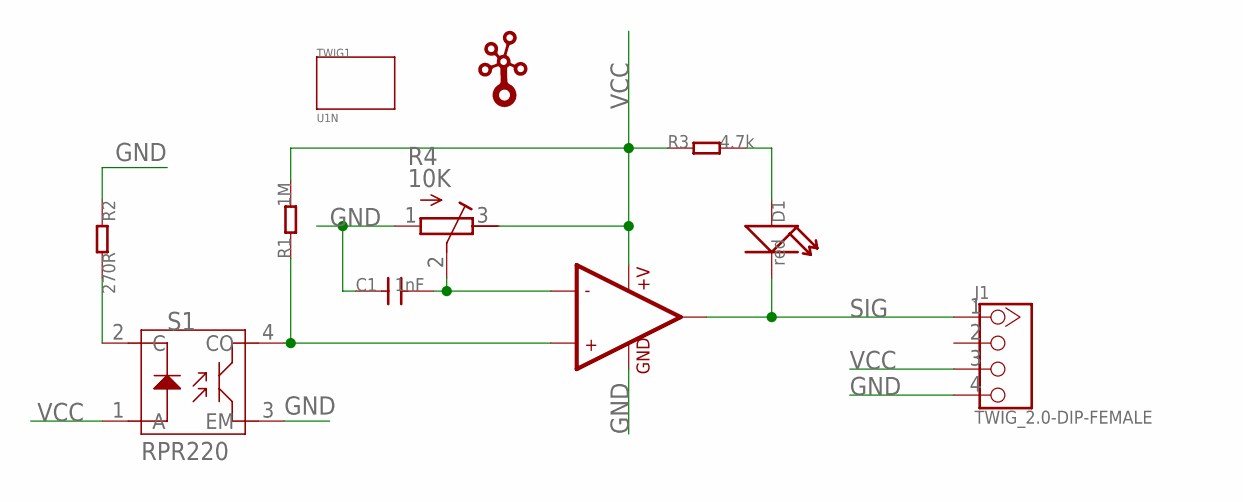
[picture p53: schematic Grove - Infrared Reflective Sensor.sch]

Parts:
C1: 1nF; 0603
D1: red; LED0603
J1: TWIG_2.0-DIP-FEMALE; 2.0_1X4
R1: 1M; 0603_S
R2: 270R; 0603_S
R3: 4.7k; 0603_S
R4: 10K; RTRIM3214W
S1: RPR220; 4P-6.4X4.9X6.5H
TWIG1: U1N
U1: 002-LMV358; SO08
U$2: TWIGLOGOTWIGLOGO_SMALL; TWIGLOGO_SMALL

Connections:
GND: C1.1, J1.4, R2.1, R4.1 (E), S1.3 (EM), U1.4 (GND)
unnamed: C1.2, R4.2 (S), U1.2 (-IN1)
unnamed: R1.1, S1.4 (CO), U1.3 (+IN1)
unnamed: R2.2, S1.2 (C)
unnamed: D1.1 (+), R3.2
SIG: D1.2 (-), J1.1, U1.1 (OUT1)
VCC: J1.3, R1.2, R3.1, R4.3 (A), S1.1 (A), U1.8 (+V)

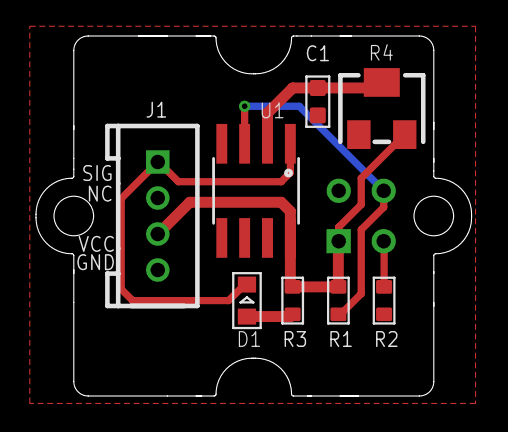
[picture p54: board Grove - Infrared Reflective Sensor.brd from above]

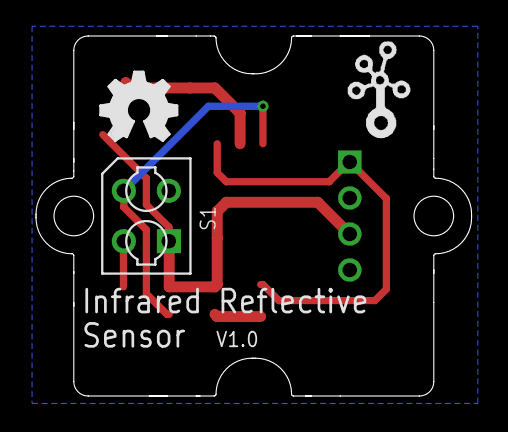
[picture p55: board Grove - Infrared Reflective Sensor.brd from below]

Board: 2 copper layers, 24.2 x 20.0 mm, 12 parts (3 on the bottom side), 7 nets.

Other parts of the board:
U$1: OSHW_FILLX150_NOTEXT
